parkourlrc/pcb-starlightk7--OpenKSK-0b556d2e34/KSK-1200A/1-640-117-14/Rev A/OpenKSK1200A.kicad_pcb

## KiCad design KSK-1200A/1-640-117-14/Rev A/OpenKSK1200A.kicad_pcb (2026-01-23, an earlier design)

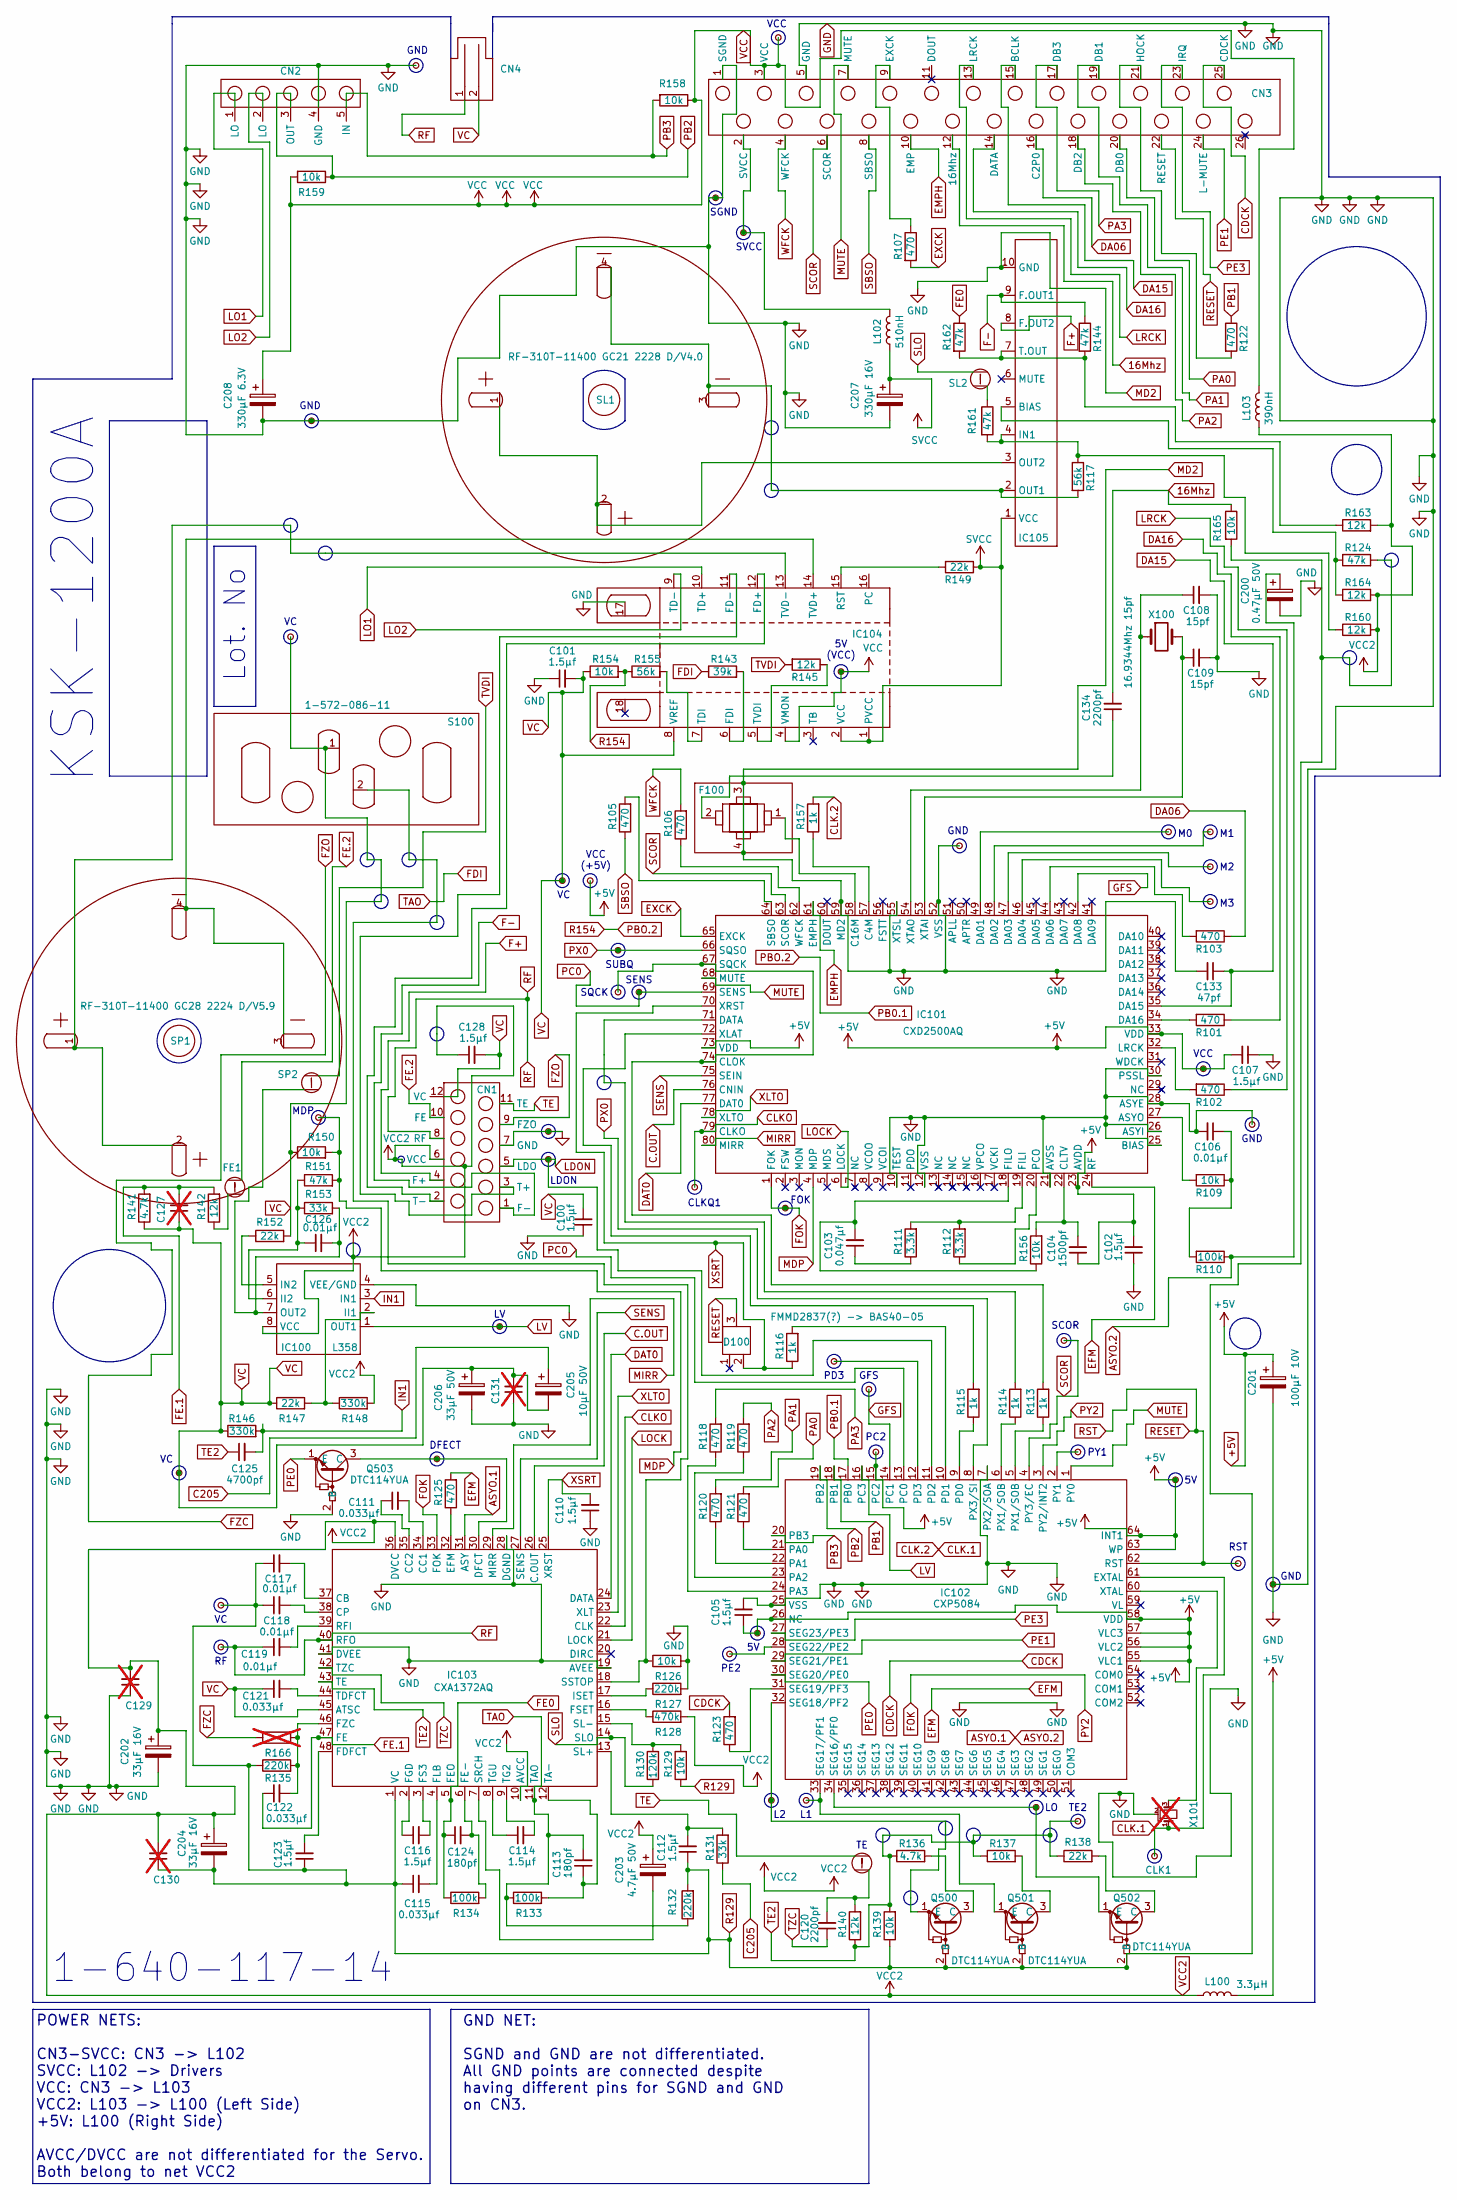
[picture p1: schematic OpenKSK1200A.kicad_sch, Open KSK-1200A]

Parts:
5V1, 5V2, 5V3: TestPoint_Small; TestPoint_Pad_D1.0mm
5V4: TestPoint_Small; TestPoint_Pad_D2.0mm
C100, C101, C102, C105, C107, C110, C112, C114, C116, C123, C128: 1.5µf; C_0805_2012Metric
C103: 0.047µf; C_0805_2012Metric
C104: 1500pf; C_0805_2012Metric
C106, C117, C118, C119, C126: 0.01µf; C_0805_2012Metric
C108, C109: 15pf; C_0805_2012Metric
C111, C115, C121, C122: 0.033µf; C_0805_2012Metric
C113, C124: 180pf; C_0805_2012Metric
C120, C134: 2200pf; C_0805_2012Metric
C125: 4700pf; C_0805_2012Metric
C127, C131: C_0805_2012Metric; not fitted
C129, C130: C_Small; C_0805_2012Metric; not fitted
C133: 47pf; C_0805_2012Metric
C200: 0.47µF 50V; THT Cap 0.5_0.5
C201: 100µF 10V; THT Cap 0.5_0.5
C202, C204: 33µF 16V; THT Cap 0.5_0.5
C203: 4.7µF 50V; THT Cap 0.5_0.5
C205: 10µF 50V; THT Cap 0.5_0.5
C206: 33µF 50V; THT Cap 0.5_0.5
C207: 330µF 16V; THT Cap 0.5_0.5
C208: 330µF 6.3V; THT Cap 0.5_0.5
CLK1: TestPoint_Small; TestPoint_Pad_D1.0mm
CLKQ1: TestPoint_Small; TestPoint_Pad_D1.0mm
CN1: CN1
CN2: CN2
CN3: CN3
CN4: CN4
D100: FMMD2837(?) -> BAS40-05; SOT-23_Handsoldering
DFECT1: TestPoint_Small; TestPoint_Pad_D1.0mm
F100: 350nH (L/R); F100
FE1: Jumper
FOK1: TestPoint_Small; TestPoint_Pad_D1.0mm
GFS1: TestPoint_Small; TestPoint_Pad_D2.0mm
GND1, GND2, GND4, GND5, GND6: TestPoint_Small; TestPoint_Pad_D2.0mm
GND3: TestPoint_Small; TestPoint_Pad_D1.0mm
IC100: L358; LM358
IC101: CXD2500AQ
IC102: CXP5084
IC103: CXA1372AQ; CXA1372Q
IC104: AN8377N
IC105: BA6294
L1, L2: TestPoint_Small; TestPoint_Pad_D1.0mm
L100: 3.3μH; L_1206_3216Metric
L102: 510nH; L_1806_4516Metric_Pad1.45x1.90mm_HandSolder
L103: 390nH; L_1206_3216Metric
LDON1: TestPoint_Small; TestPoint_Pad_D2.0mm
LO1: TestPoint_Small; TestPoint_Pad_D2.0mm
LV1: TestPoint_Small; TestPoint_Pad_D2.0mm
M0, M1, M2, M3: TestPoint_Small; TestPoint_Pad_D2.0mm
MDP1: TestPoint_Small; TestPoint_Pad_D2.0mm
PC2: TestPoint_Small; TestPoint_Pad_D1.0mm
PD3: TestPoint_Small; TestPoint_Pad_D2.0mm
PE2: TestPoint_Small; TestPoint_Pad_D2.0mm
PY1: TestPoint_Small; TestPoint_Pad_D2.0mm
Q500, Q501, Q502, Q503: DTC114YUA; SOT-323_SC-70
R101, R102, R103, R105, R106, R107, R118, R119, R120, R121, R122, R123, R125: 470; R_0805_2012Metric
R109, R126, R129, R137, R139, R150, R154, R156, R158, R159, R165: 10k; R_0805_2012Metric
R110, R133, R134: 100k; R_0805_2012Metric
R111, R112: 3.3k; R_0805_2012Metric
R113, R114, R115, R116, R157: 1k; R_0805_2012Metric
R117, R155: 56k; R_0805_2012Metric
R124, R144, R151, R161, R162: 47k; R_0805_2012Metric
R127, R132, R135: 220k; R_0805_2012Metric
R128: 470k; R_0805_2012Metric
R130: 120k; R_0805_2012Metric
R131, R153: 33k; R_0805_2012Metric
R136, R141: 4.7k; R_0805_2012Metric
R138, R147, R149, R152: 22k; R_0805_2012Metric
R140, R142, R145, R160, R163, R164: 12k; R_0805_2012Metric
R143: 39k; R_0805_2012Metric
R146, R148: 330k; R_0805_2012Metric
R166: R_0805_2012Metric; not fitted
RF1: TestPoint_Pad_D2.0mm
RST1: TestPoint_Small; TestPoint_Pad_D2.0mm
S100: 1-572-086-11; LimitSwitch
SCOR1: TestPoint_Small; TestPoint_Pad_D2.0mm
SENS1: TestPoint_Small; TestPoint_Pad_D1.0mm
SGND1: TestPoint_Small; TestPoint_Pad_D2.0mm
SL1: RF-310T-11400 GC21 2228 D/V4.0; SL1
SL2: Jumper
SP1: RF-310T-11400 GC28 2224 D/V5.9; SP1
SP2: Jumper
SQCK1: TestPoint_Small; TestPoint_Pad_D1.0mm
SUBG1: TestPoint_Small; TestPoint_Pad_D1.0mm
SVCC1: TestPoint_Small; TestPoint_Pad_D2.0mm
TE1: Jumper
TE2: TestPoint_Small; TestPoint_Pad_D2.0mm
VC1, VC2: TestPoint_Pad_D1.0mm
VC3, VC4: TestPoint_Small; TestPoint_Pad_D2.0mm
VCC2: TestPoint_Small; TestPoint_Pad_D2.0mm
VCC3: TestPoint_Small; TestPoint_Pad_D1.0mm
X100: 16.9344Mhz 15pf; Crystal_HC18-U_Vertical
X101: Crystal_HC49-U-3Pin_Vertical; not fitted

Connections:
16Mhz: C134.2, CN3.12 (16Mhz), R165.1
+5V: 5V1.1, 5V2.1, 5V4.1, C102.2, C104.1, C105.1, C107.2, C201.1, IC101.23 (AVDD), IC101.33 (VDD), IC101.73 (VDD), IC102.15 (PC2), IC102.26 (NC), IC102.55 (VLC1), IC102.56 (VLC2), IC102.57 (VLC3), IC102.58 (VDD), IC102.63 (WP), IC102.64 (INT1), L100.2, PC2.1, VCC3.1
ASYO.1: C200.1, IC103.31 (ASY), R110.1
C205: C205.1, R131.1
C.OUT: IC101.76 (CNIN), IC103.26 (C.OUT)
CDCK: CN3.25 (CDCK), R123.2
CLK.1: CLK1.1, IC102.61 (EXTAL), R157.2, X101.1
CLKO: CLKQ1.1, IC101.79 (CLKO), IC103.22 (CLK)
DA06: CN3.16 (C2P0), R103.1
DA15: C133.1, CN3.15 (BCLK), IC101.35 (DA15)
DA16: CN3.14 (DATA), R101.1
DAT0: IC101.77 (DAT0), IC103.24 (DATA)
EFM: IC101.24 (RF), R125.2
EMPH: CN3.10 (EMP), IC101.61 (EMPH)
EXCK: IC101.65 (EXCK), R107.2
F+: CN1.4 (F+), IC105.8 (F.OUT2)
F-: CN1.1 (F-), IC105.9 (F.OUT1), R144.1
FDI: C113.2, IC103.11 (TAO), R132.1, R133.1, R143.1
FE0: C124.1, IC103.5 (FEO), R134.1, R162.1
FE.1: C122.1, C127.2, IC103.47 (FE), R141.2, R142.2
FE.2: CN1.10 (FE), FE1.1
FOK: FOK1.1, IC101.1 (FOK), IC102.3 (PY2/INT2), IC103.33 (FOK)
FZC: CN1.9 (FZO), R166.1
GFS: GFS1.1, IC101.42 (DA08), IC102.14 (PC1)
GND: C100.1, C101.1, C102.1, C105.2, C106.2, C107.1, C108.2, C109.2, C110.1, C129.1, C131.1, C133.2, C200.2, C201.2, C202.2, C206.2, C207.2, C208.2, CN1.7 (GND), CN2.4 (GND), CN3.1 (SGND), CN3.5 (GND), F100.3, F100.4, GND1.1, GND2.1, GND3.1, GND4.1, GND5.1, GND6.1, IC100.4 (VEE/GND), IC101.10 (TEST), IC101.12 (VSS), IC101.21 (AVSS), IC101.25 (BIAS), IC101.26 (ASYI), IC101.28 (ASYE), IC101.30 (PSSL), IC101.52 (VSS), IC101.55 (XTSL), IC101.59 (MD2), IC102.7 (PX2/SOA), IC102.25 (VSS), IC103.19 (AVEE), IC103.28 (DGND), IC103.41 (DVEE), IC104.17, IC105.10 (GND), Q503.2 (B), R126.2, R127.2, SGND1.1, X101.2
IN1: C125.2, IC100.3 (IN1), R146.2
LDON: CN1.5 (LDO), IC102.11 (PD2), LDON1.1
LO1: CN2.1 (LO), IC104.10 (TD+)
LO2: CN2.2 (LO), IC104.9 (TD-)
LOCK: IC101.6 (LOCK), IC103.21 (LOCK)
LRCK: CN3.13 (LRCK), R102.1
LV: IC100.1 (OUT1), IC102.16 (PC3), LV1.1
MDP: IC101.4 (MDP), MDP1.1, R150.2, R151.2
MIRR: IC101.80 (MIRR), IC103.29 (MIRR)
MUTE: CN3.7 (MUTE), IC101.68 (MUTE), IC102.1 (PY0)
unnamed: C103.1, R111.1
unnamed: C106.1, R109.1, R110.2
unnamed: C120.2, R140.2, TE1.2
unnamed: C134.1, F100.2
unnamed: CN1.3 (T+), IC104.11 (FD-)
unnamed: CN1.2 (T-), IC104.12 (FD+)
unnamed: CN3.9 (EXCK), R107.1
unnamed: CN3.21 (HOCK), R122.2
unnamed: CN3.2 (SVCC), L102.2, SVCC1.1
unnamed: FE1.2, R142.1
unnamed: IC100.2 (II1), R147.2, R148.1
unnamed: C126.1, IC100.6 (II2), R151.1, R153.1
unnamed: IC100.5 (IN2), R152.1
unnamed: C126.2, IC100.7 (OUT2), R153.2, SP2.2
unnamed: IC101.27 (ASYO), R109.2
unnamed: IC101.57 (C4M), R157.1
unnamed: F100.1, IC101.58 (C16M)
unnamed: IC101.67 (SQCK), IC101.74 (CLOK), R113.2, SQCK1.1
unnamed: C104.2, IC101.22 (CLTV), R156.2
unnamed: IC101.49 (DA01), M0.1
unnamed: IC101.48 (DA02), M1.1
unnamed: IC101.47 (DA03), M2.1
unnamed: IC101.46 (DA04), M3.1
unnamed: IC101.44 (DA06), R103.2
unnamed: IC101.34 (DA16), R101.2
unnamed: IC101.71 (DATA), R114.2
unnamed: IC101.19 (FILI), R111.2, R112.2
unnamed: C103.2, IC101.18 (FILO), R156.1
unnamed: IC101.32 (LRCK), R102.2
unnamed: IC101.20 (PCO), R112.1
unnamed: IC101.64 (SBSO), R105.2
unnamed: IC101.62 (WFCK), R106.1
unnamed: IC101.72 (XLAT), R115.2
unnamed: C109.1, IC101.53 (XTAI), X100.2
unnamed: C108.1, IC101.54 (XTAO), X100.1
unnamed: IC102.21 (PA0), R121.1
unnamed: IC102.22 (PA1), R120.1
unnamed: IC102.23 (PA2), R119.1
unnamed: IC102.24 (PA3), R118.1
unnamed: IC102.9 (PD0), R115.1
unnamed: IC102.10 (PD1), R116.2
unnamed: IC102.12 (PD3), PD3.1
unnamed: IC102.5 (PX1/SOB), R113.1
unnamed: IC102.6 (PX1/SOB), R114.1
unnamed: IC102.2 (PY1), PY1.1
unnamed: IC102.34 (SEG16/PF0), LO1.1, Q502.1 (E)
unnamed: IC102.33 (SEG17/PF1), L1.1, Q501.1 (E)
unnamed: IC102.32 (SEG18/PF2), L2.1, Q500.1 (E)
unnamed: IC102.31 (SEG19/PF3), R123.1
unnamed: IC102.28 (SEG22/PE2), PE2.1
unnamed: IC102.60 (XTAL), X101.3
unnamed: C117.2, IC103.37 (CB)
unnamed: C111.2, IC103.34 (CC1)
unnamed: C111.1, IC103.35 (CC2)
unnamed: C118.2, IC103.38 (CP)
unnamed: DFECT1.1, IC103.30 (DFCT), Q503.3 (C)
unnamed: IC103.32 (EFM), R125.1
unnamed: C123.2, IC103.48 (FDFCT)
unnamed: C124.2, IC103.6 (FE-), R134.2
unnamed: C116.1, IC103.2 (FGD)
unnamed: C115.2, IC103.4 (FLB)
unnamed: C116.2, IC103.3 (FS3)
unnamed: IC103.16 (FSET), R128.1
unnamed: C122.2, IC103.46 (FZC), R135.2, R166.2
unnamed: IC103.17 (ISET), R127.1
unnamed: C119.2, IC103.39 (RFI)
unnamed: C112.2, IC103.13 (SL+), R131.2
unnamed: IC103.15 (SL-), R129.2, R130.2
unnamed: C203.2, IC103.7 (SRCH)
unnamed: IC103.18 (SSTOP), R126.1, S100.2
unnamed: C113.1, IC103.12 (TA-), R133.2
unnamed: C121.2, IC103.44 (TDFCT)
unnamed: C114.2, IC103.9 (TG2)
unnamed: C114.1, IC103.8 (TGU)
unnamed: IC104.6 (FDI), R143.2
unnamed: IC104.15 (RST), R149.2
unnamed: IC104.7 (TDI), R155.2
unnamed: IC104.14 (TVD+), SP1.3, SP1.4
unnamed: IC104.13 (TVD-), SP1.1, SP1.2
unnamed: IC104.5 (TVDI), R145.1
unnamed: IC105.5 (BIAS), R124.1, R164.1
unnamed: IC105.4 (IN1), R117.1, R160.1, R161.2
unnamed: IC105.2 (OUT1), R117.2, SL1.3, SL1.4
unnamed: IC105.3 (OUT2), SL1.1, SL1.2
unnamed: IC105.7 (T.OUT), R144.2, R162.2, R163.1
unnamed: Q500.3 (C), R136.2
unnamed: Q501.3 (C), R137.2
unnamed: Q502.3 (C), R138.2
unnamed: R161.1, SL2.2
PA0: CN3.20 (DB0), R121.2
PA1: CN3.19 (DB1), R120.2
PA2: CN3.18 (DB2), R119.2
PA3: CN3.17 (DB3), R118.2
PB0.1: IC102.17 (PB0), R154.2, R155.1
PB1: IC102.18 (PB1), R122.1
PB2: CN2.3 (OUT), IC102.19 (PB2), R159.1
PB3: CN2.5 (IN), IC102.20 (PB3), R158.2
PC0: IC101.69 (SENS), IC102.13 (PC0), SENS1.1
PE0: IC102.30 (SEG20/PE0), Q503.1 (E)
PE1: CN3.24 (L-MUTE), IC102.29 (SEG21/PE1)
PE3: CN3.23 (IRQ), IC102.27 (SEG23/PE3)
PX0: IC101.66 (SQSO), IC102.8 (PX3/SI), SUBG1.1
R129: C112.1, C115.1, C117.1, C118.1, C123.1, C130.1, C204.2, IC103.1 (VC), Q500.2 (B), Q501.2 (B), Q502.2 (B), R124.2, R129.1, R132.2, R135.1, R139.1, R165.2, VC2.1
RESET: CN3.22 (RESET), D100.3, IC102.62 (RST), RST1.1
RF: C119.1, CN1.8 (RF), CN4.1, IC103.40 (RFO), RF1.1
SBSO: CN3.8 (SBSO), R105.1
SCOR: CN3.6 (SCOR), IC101.63 (SCOR), IC102.4 (PY3/EC), SCOR1.1
SENS: IC101.75 (SEIN), IC103.27 (SENS)
SLO: IC103.14 (SLO), R130.1, SL2.1
SVCC: C207.1, IC104.1 (PVCC), IC104.2 (VCC), IC105.1 (VCC), L102.1, R149.1
TE: CN1.11 (TE), TE1.1
TE2: C125.1, IC103.43 (TE), R136.1, R137.1, R138.1, R139.2, R140.1, TE2.1
TVDI: R145.2, SP2.1
TZC: C120.1, IC103.42 (TZC)
VC: C100.2, C101.2, C121.1, C127.1, C128.2, C131.2, C205.2, C206.1, CN1.12 (VC), CN4.2, IC103.45 (ATSC), IC104.8 (VREF), R141.1, R146.1, R147.1, R150.1, R152.2, R154.1, S100.1, VC1.1, VC3.1, VC4.1
VCC: 5V3.1, C208.1, CN3.3 (VCC), IC104.4 (VMON), L103.2, R158.1, R159.2, VCC2.1
VCC2: C128.1, C129.2, C130.2, C202.1, C203.1, C204.1, CN1.6 (VCC), IC100.8 (VCC), IC103.10 (AVCC), IC103.36 (DVCC), L100.1, L103.1, R128.2, R148.2, R160.2, R163.2, R164.2
WFCK: CN3.4 (WFCK), R106.2
XLTO: IC101.78 (XLTO), IC103.23 (XLT)
XSRT: C110.2, D100.2, IC101.70 (XRST), IC103.25 (XRST), R116.1

Notes on the sheet:
1-640-117-14
VCC
SCOR
LDON
GND
PD3
SVCC
SENS
FOK
SQCK
GFS
SUBQ
TE2
SGND
GND NET: SGND and GND are not differentiated. All GND points are connected despite having different pins for SGND and GND on CN3.
CLKQ1
5V (VCC)
VCC (+5V)
POWER NETS: CN3-SVCC: CN3 -> L102 SVCC: L102 -> Drivers VCC: CN3 -> L103 VCC2: L103 -> L100 (Left Side) +5V: L100 (Right Side) AVCC/DVCC are not differentiated for the Servo. Both belong to net VCC2
Lot. No
PC2
RST
PE2
DFECT
MDP
KSK-1200A
PY1

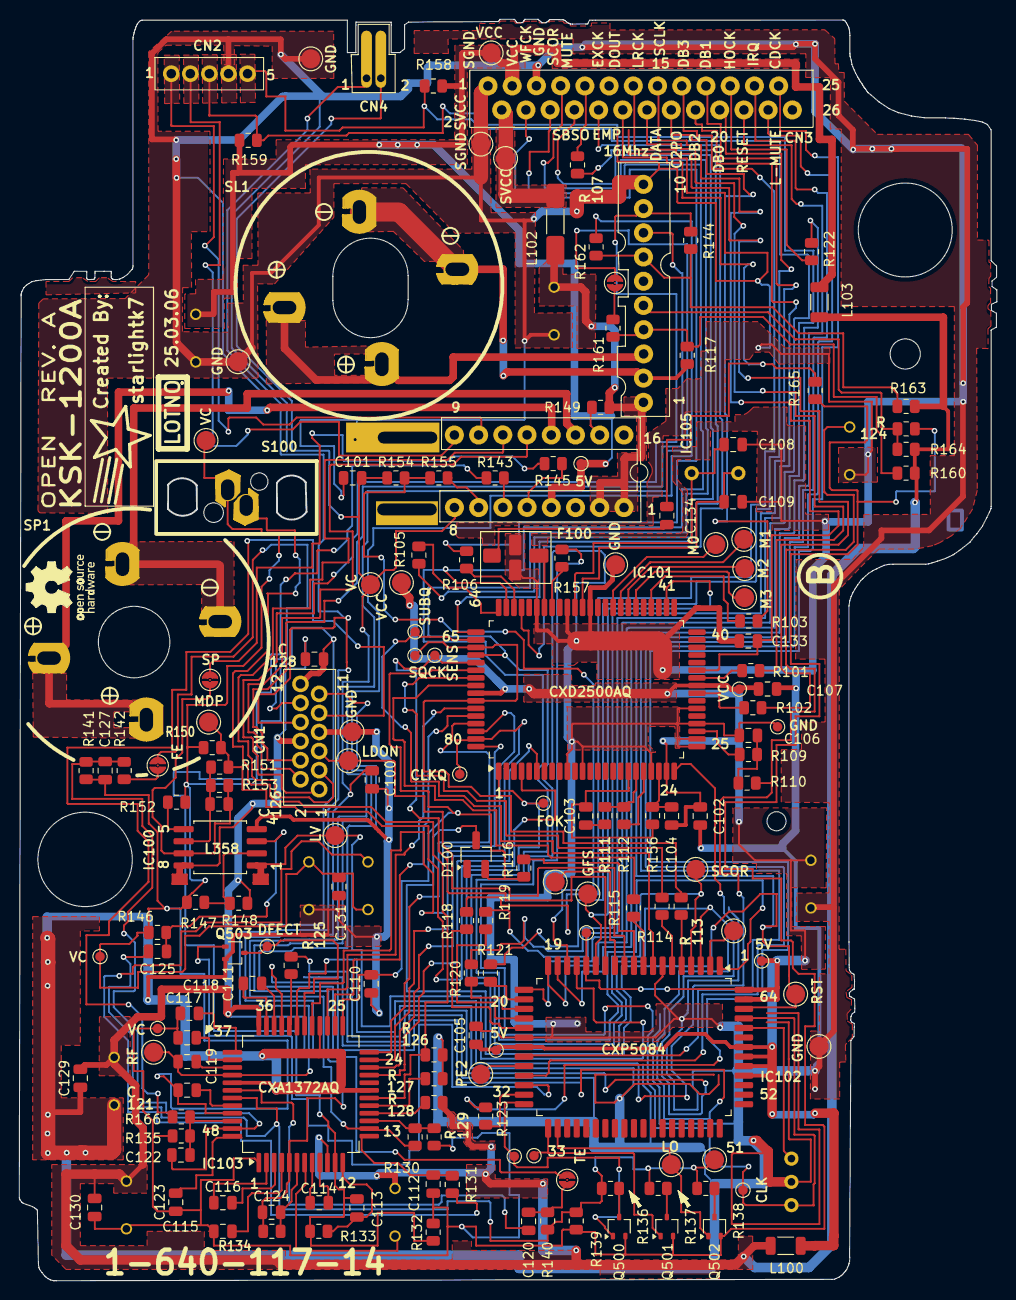
[picture p2: board OpenKSK1200A.kicad_pcb from above]

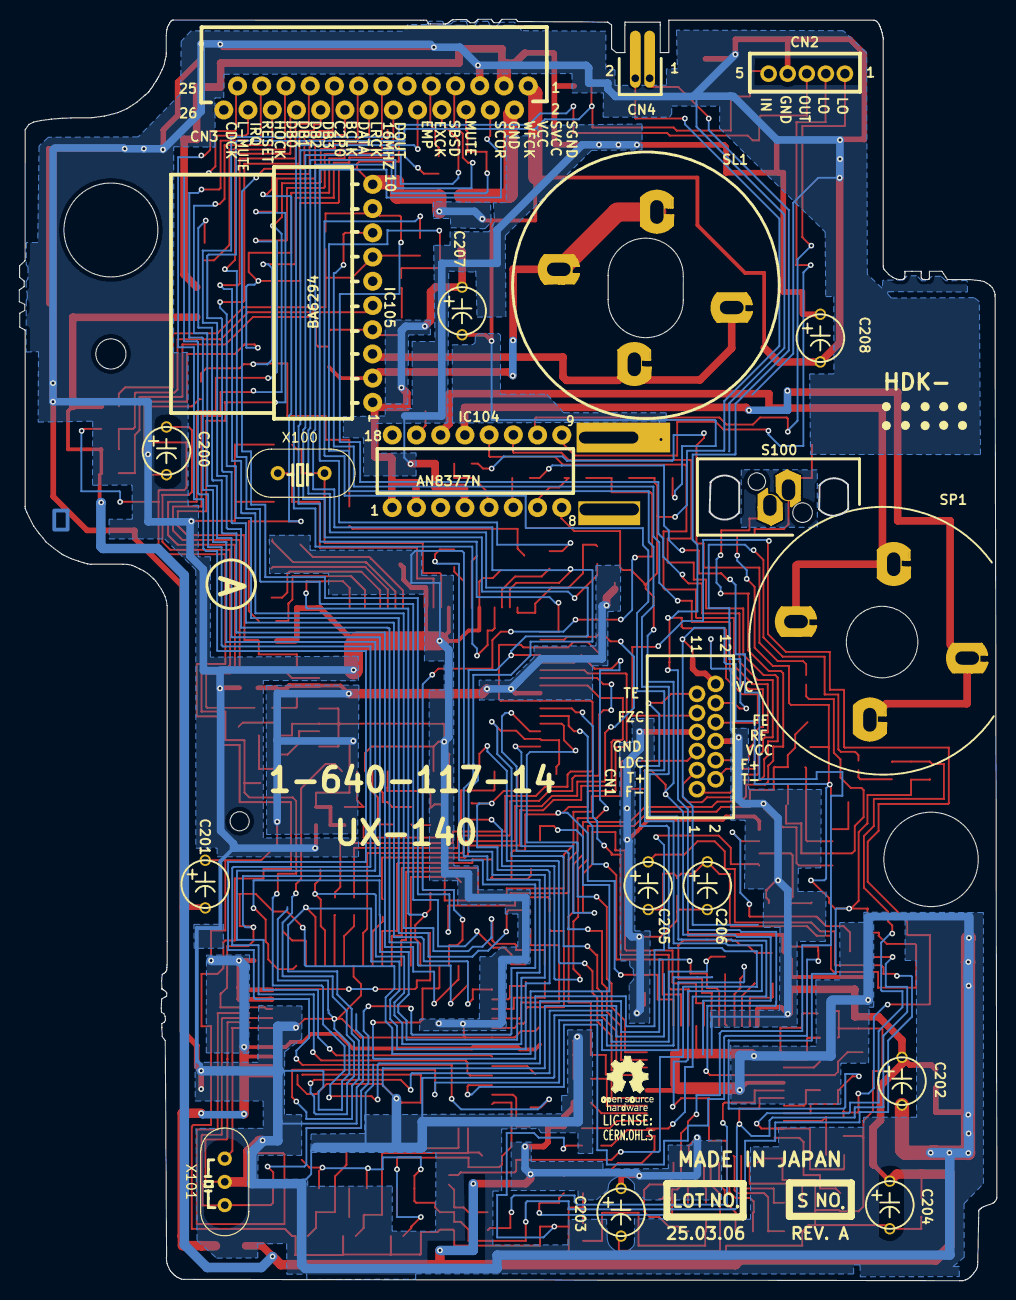
[picture p3: board OpenKSK1200A.kicad_pcb from below]

Board: 2 copper layers, 102.5 x 132.3 mm, 179 parts (14 on the bottom side), 155 nets.
