parkourlrc/pcb-starlightk7--OpenKSK-0b556d2e34/DebugAndCalibrationTool/Rev A/DebugAndCalibrationTool.kicad_pcb

## KiCad design DebugAndCalibrationTool/Rev A/DebugAndCalibrationTool.kicad_pcb (2026-01-23)

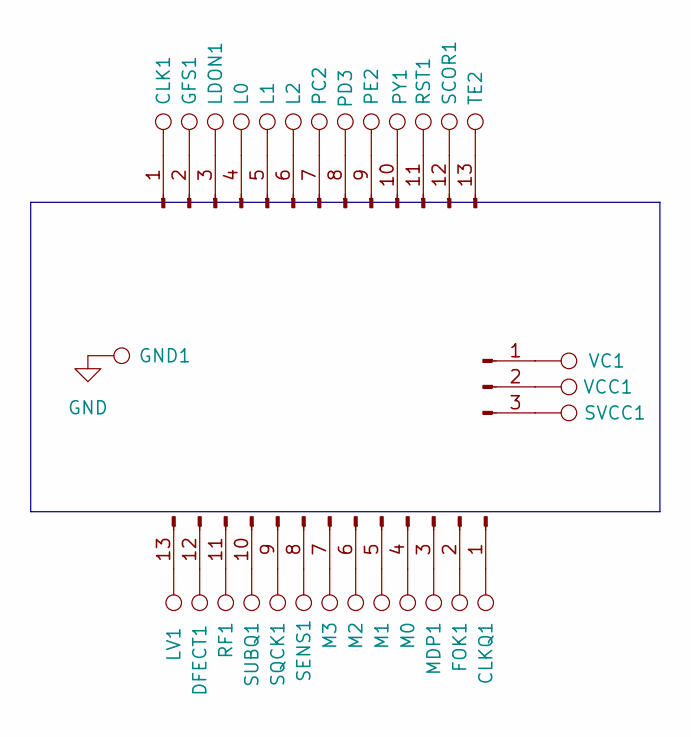
[picture p4: schematic DebugAndCalibrationTool.kicad_sch, KSK-1200A Debug & Calibration Tool]

Parts:
CLK1: TestPoint; TestPoint_Pad_D2.0mm
CLKQ1: TestPoint; TestPoint_Pad_D2.0mm
DFECT1: TestPoint; TestPoint_Pad_D2.0mm
FOK1: TestPoint; TestPoint_Pad_D2.0mm
GFS1: TestPoint; TestPoint_Pad_D2.0mm
GND1: TestPoint; TestPoint_Pad_D2.0mm
J4: Conn_01x04_Pin; PinHeader_1x08_P2.54mm_Vertical
J5, J6: Conn_01x13_Pin; PinHeader_1x26_P2.54mm_Vertical
L0, L1, L2: TestPoint; TestPoint_Pad_D2.0mm
LDON1: TestPoint; TestPoint_Pad_D2.0mm
LV1: TestPoint; TestPoint_Pad_D2.0mm
M0, M1, M2, M3: TestPoint; TestPoint_Pad_D2.0mm
MDP1: TestPoint; TestPoint_Pad_D2.0mm
PC2: TestPoint; TestPoint_Pad_D2.0mm
PD3: TestPoint; TestPoint_Pad_D2.0mm
PE2: TestPoint; TestPoint_Pad_D2.0mm
PY1: TestPoint; TestPoint_Pad_D2.0mm
RF1: TestPoint; TestPoint_Pad_D2.0mm
RST1: TestPoint; TestPoint_Pad_D2.0mm
SCOR1: TestPoint; TestPoint_Pad_D2.0mm
SENS1: TestPoint; TestPoint_Pad_D2.0mm
SQCK1: TestPoint; TestPoint_Pad_D2.0mm
SUBQ1: TestPoint; TestPoint_Pad_D2.0mm
SVCC1: TestPoint; TestPoint_Pad_D2.0mm
TE2: TestPoint; TestPoint_Pad_D2.0mm
VC1: TestPoint; TestPoint_Pad_D2.0mm
VCC1: TestPoint; TestPoint_Pad_D2.0mm

Connections:
GND: GND1.1
unnamed: J4.1, VC1.1
unnamed: J4.2, VCC1.1
unnamed: J4.3, SVCC1.1
unnamed: CLKQ1.1, J5.1
unnamed: FOK1.1, J5.2
unnamed: J5.3, MDP1.1
unnamed: J5.4, M0.1
unnamed: J5.5, M1.1
unnamed: J5.6, M2.1
unnamed: J5.7, M3.1
unnamed: J5.8, SENS1.1
unnamed: J5.9, SQCK1.1
unnamed: J5.10, SUBQ1.1
unnamed: J5.11, RF1.1
unnamed: DFECT1.1, J5.12
unnamed: J5.13, LV1.1
unnamed: CLK1.1, J6.1
unnamed: GFS1.1, J6.2
unnamed: J6.3, LDON1.1
unnamed: J6.4, L0.1
unnamed: J6.5, L1.1
unnamed: J6.6, L2.1
unnamed: J6.7, PC2.1
unnamed: J6.8, PD3.1
unnamed: J6.9, PE2.1
unnamed: J6.10, PY1.1
unnamed: J6.11, RST1.1
unnamed: J6.12, SCOR1.1
unnamed: J6.13, TE2.1

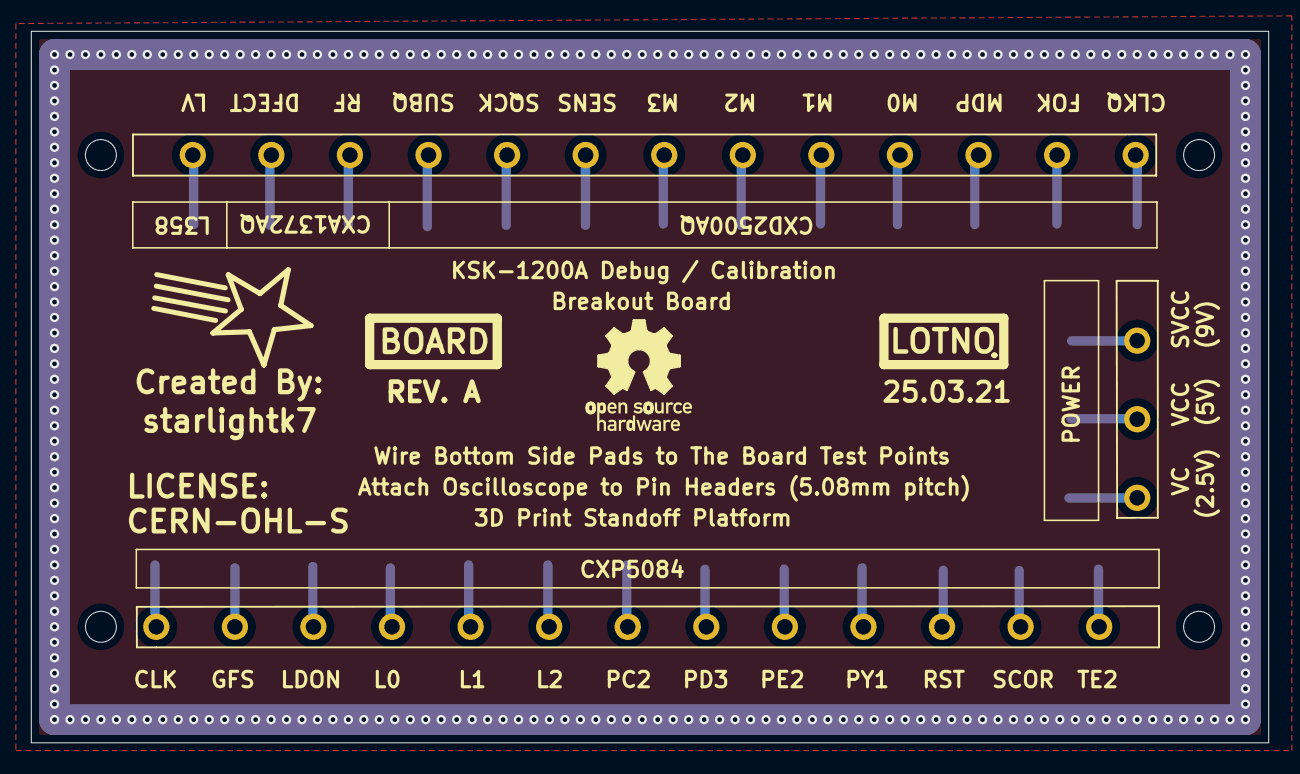
[picture p5: board DebugAndCalibrationTool.kicad_pcb from above]

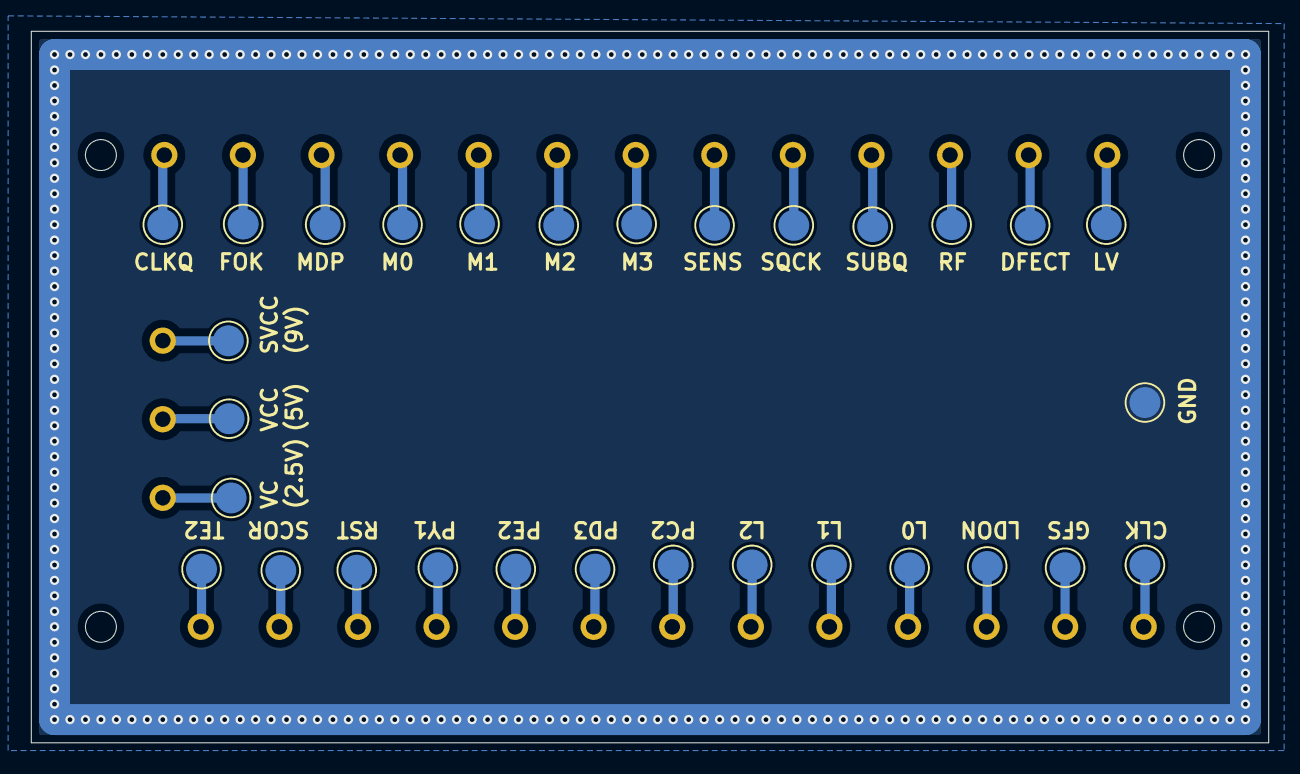
[picture p6: board DebugAndCalibrationTool.kicad_pcb from below]

Board: 2 copper layers, 80.0 x 46.0 mm, 33 parts (30 on the bottom side), 29 nets.
