parkourlrc/pcb-starlightk7--OpenKSK-0b556d2e34/CMK-81X/Rev A/CMK-81X.kicad_pcb

## KiCad design CMK-81X/Rev A/CMK-81X.kicad_pcb (2026-01-23)

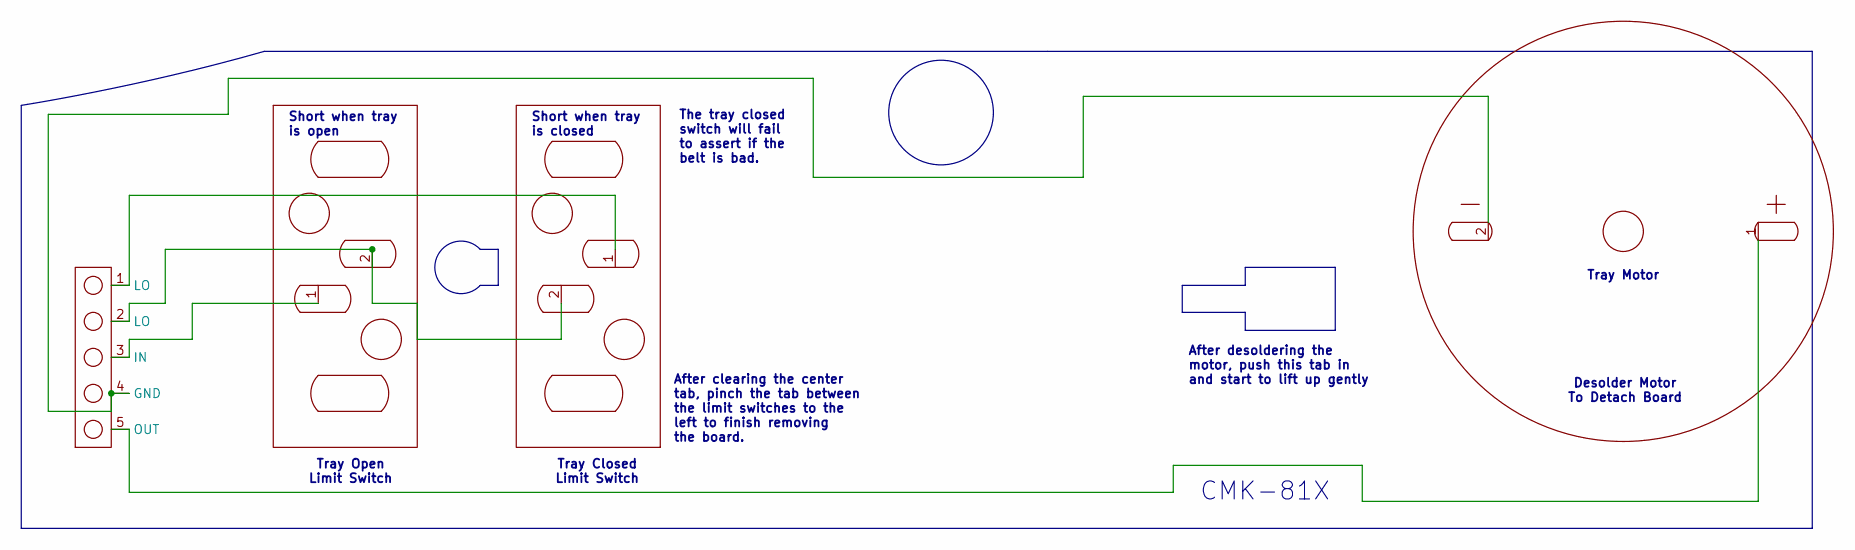
[picture p7: schematic CMK-81X.kicad_sch, OpenKSK CMK-81X]

Parts:
CN1: CN2
M1: Eject Motor
S1, S2: LimitSwitch

Connections:
unnamed: CN1.4 (GND), M1.2
unnamed: CN1.3 (IN), S1.1
unnamed: CN1.1 (LO), S2.1
unnamed: CN1.2 (LO), S1.2, S2.2
unnamed: CN1.5 (OUT), M1.1

Notes on the sheet:
Short when tray is closed
Tray Open Limit Switch
CMK-81X
Desolder Motor To Detach Board
The tray closed switch will fail to assert if the belt is bad.
Tray Motor
After desoldering the motor, push this tab in and start to lift up gently
Tray Closed Limit Switch
After clearing the center tab, pinch the tab between the limit switches to the left to finish removing the board.
Short when tray is open

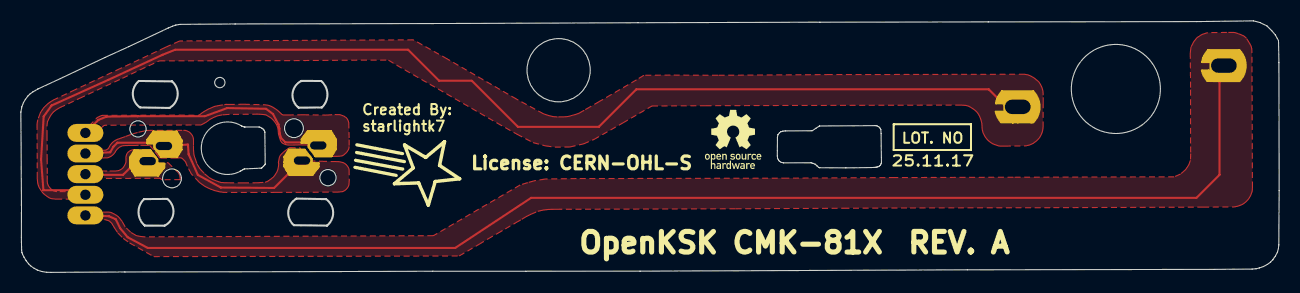
[picture p8: board CMK-81X.kicad_pcb from above]

Board: 2 copper layers, 122.1 x 24.4 mm, 4 parts (0 on the bottom side), 5 nets.
