parkourlrc/pcb-starlightk7--OpenKSK-0b556d2e34/(notices)

Notices in the files:
CMKS-81X/Rev A/CMKS-81X.kicad_sch:
License: CERN-OHL-S
